JJendryka/AirMonitor/AirMonitor.kicad_pcb

## KiCad design AirMonitor.kicad_pcb (2023-12-08)

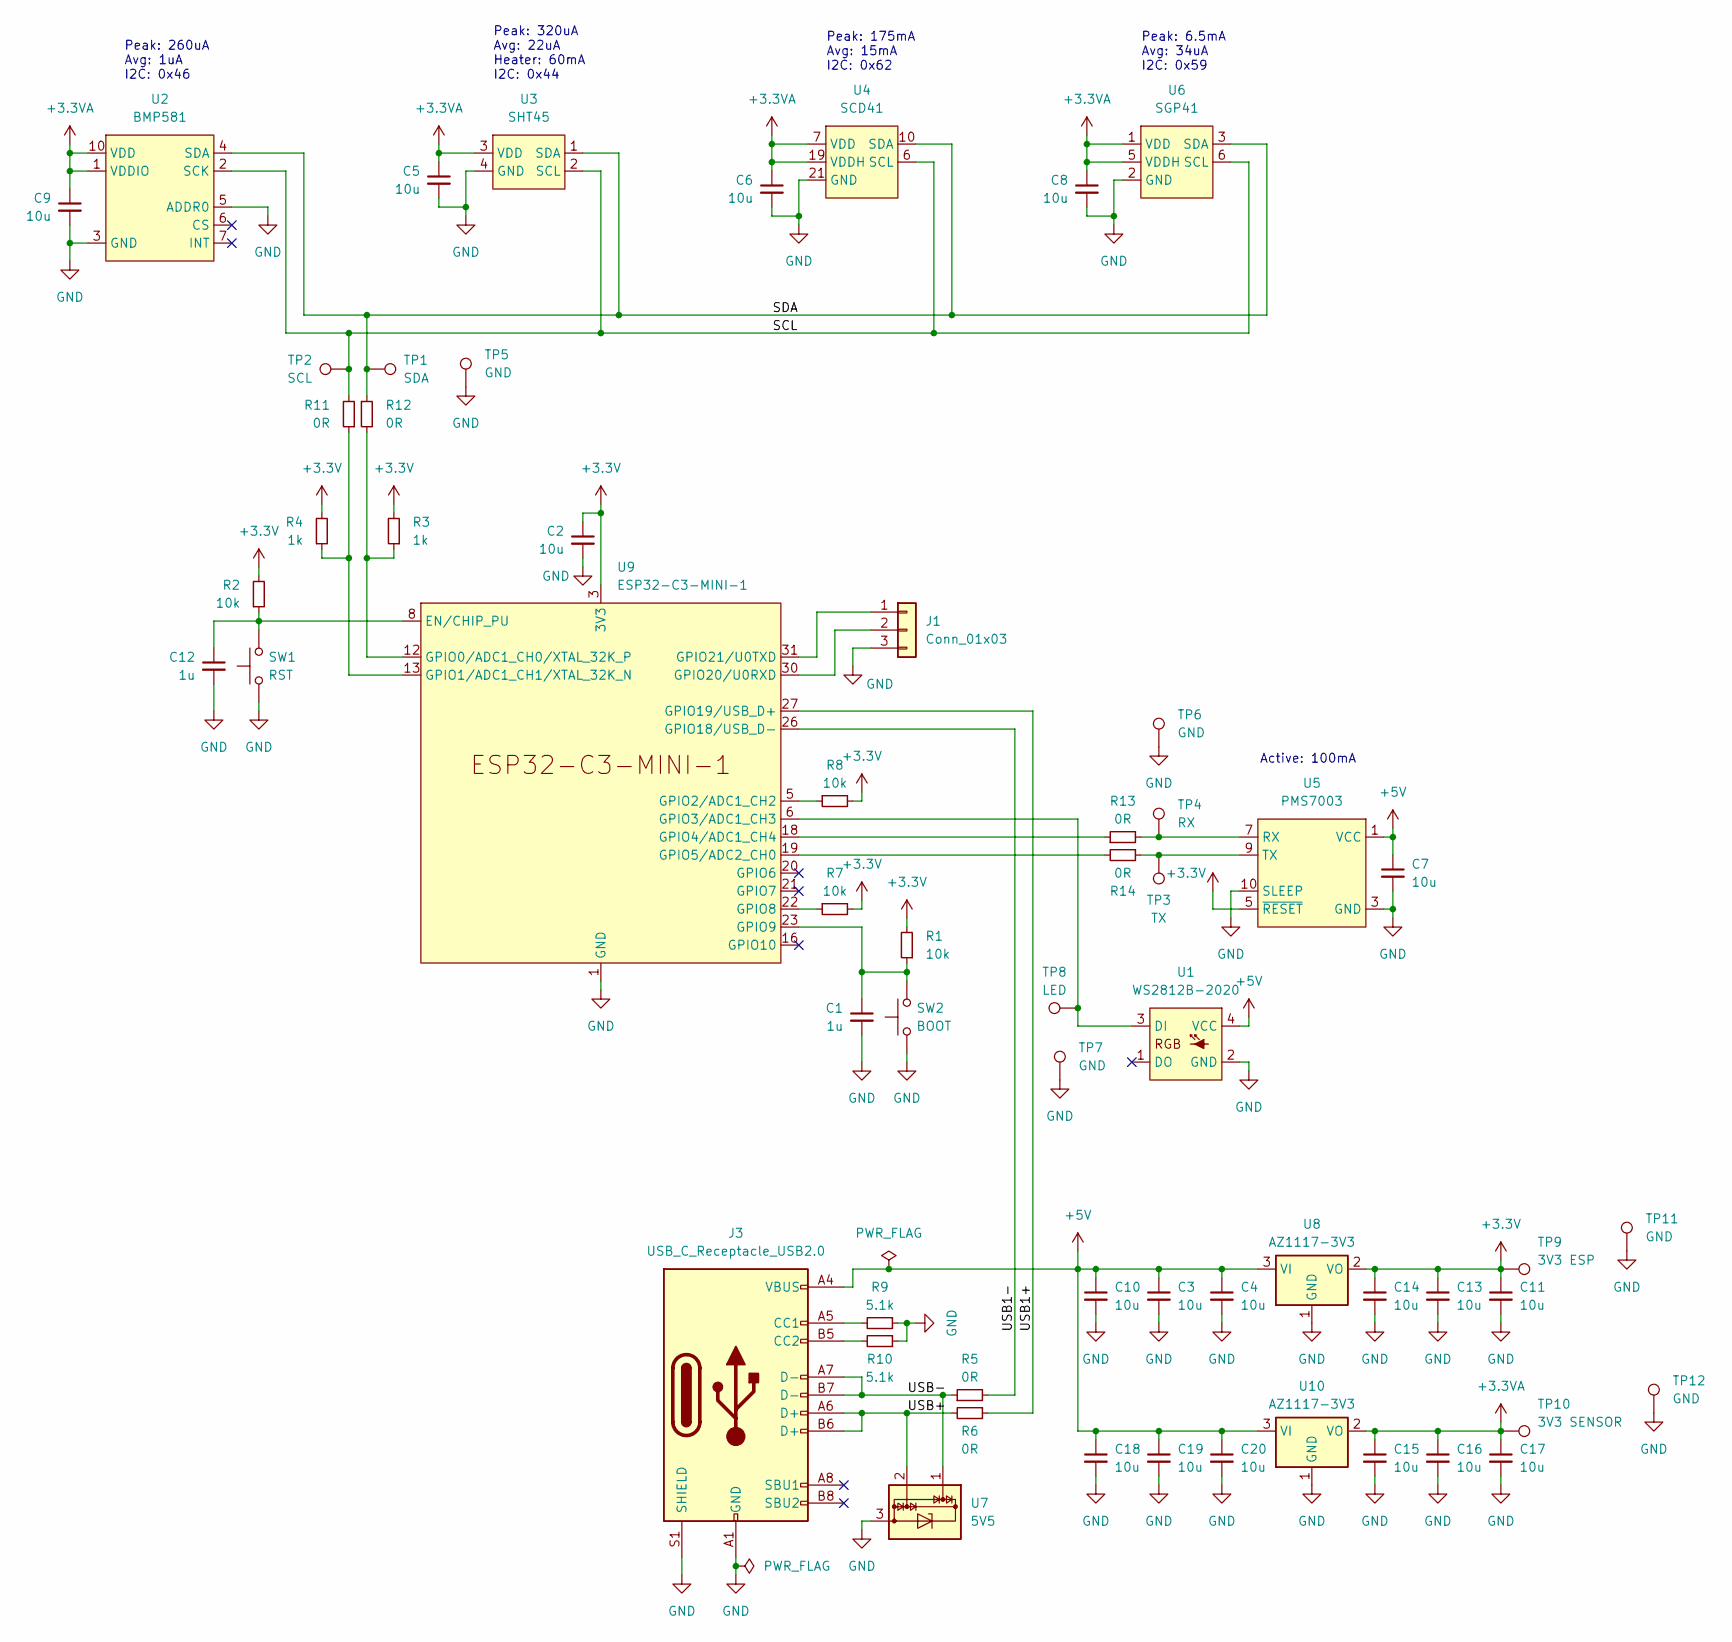
[picture p1: schematic AirMonitor.kicad_sch]

Parts:
C1, C12: 1u; C_0805_2012Metric
C2, C3, C4, C5, C6, C7, C8, C9, C10, C11, C13, C14, C15, C16, C17, C18, C19, C20: 10u; C_0805_2012Metric
J1: Conn_01x03; PinHeader_1x03_P2.54mm_Vertical_SMD_Pin1Left
J3: USB_C_Receptacle_USB2.0; USB4105-GF-A; MPN USB4105-GF-A-120; Mouser 640-USB4105-GF-A-120
R1, R2, R7, R8: 10k; R_0805_2012Metric
R3, R4: 1k; R_0805_2012Metric
R5, R6, R11, R12, R13, R14: 0R; R_0402_1005Metric_Pad0.72x0.64mm_HandSolder
R9, R10: 5.1k; R_0805_2012Metric
SW1: RST; SW_SPST_B3S-1000; MPN B3S-1000; Mouser 653-B3S-1000
SW2: BOOT; SW_SPST_B3S-1000; MPN B3S-1000; Mouser 653-B3S-1000
TP1: SDA; TestPoint_Pad_D1.0mm
TP2: SCL; TestPoint_Pad_D1.0mm
TP3: TX; TestPoint_Pad_D1.0mm
TP4: RX; TestPoint_Pad_D1.0mm
TP5, TP6, TP7, TP11, TP12: GND; TestPoint_Pad_D1.0mm
TP8: LED; TestPoint_Pad_D1.0mm
TP9: 3V3 ESP; TestPoint_Pad_D1.0mm
TP10: 3V3 SENSOR; TestPoint_Pad_D1.0mm
U1: WS2812B-2020; MPN 4684; Mouser 485-4684 - THIS IS A 10x PACK
U2: BMP581; MPN BMP581; Mouser 262-BMP581
U3: SHT45; SHT4x; MPN SHT45-AD1F-R2; Mouser 403-SHT45-AD1F-R2
U4: SCD41; SCD4x; MPN SCD41-D-R2; Mouser 403-SCD41-D-R2
U5: PMS7003; MPN PMS7003 + 20021311-00010T4LF; Mouser 649-221311-00010T4LF
U6: SGP41; DFN-6_EP_2.44x2.44_Pitch0.8mm; MPN SGP41-D-R4; Mouser 403-SGP41-D-R4
U7: 5V5; SOT-323_SC-70; MPN TPD2E2U06DCKR; Mouser 595-TPD2E2U06DCKR
U8, U10: AZ1117-3V3; SOT-223-3_TabPin2; MPN AZ1117IH-3.3TRG1; Mouser 621-AZ1117IH-3.3TRG1
U9: ESP32-C3-MINI-1

Connections:
+3.3V: C2.1, C11.1, C13.1, C14.1, R1.2, R2.2, R3.2, R4.2, R7.2, R8.2, TP9.1, U5.5 (~RESET), U8.2 (VO), U9.3 (3V3)
+3.3VA: C5.1, C6.1, C8.1, C9.1, C15.1, C16.1, C17.1, TP10.1, U2.1 (VDDIO), U2.10 (VDD), U3.3 (VDD), U4.7 (VDD), U4.19 (VDDH), U6.1 (VDD), U6.5 (VDDH), U10.2 (VO)
+5V: C3.1, C4.1, C7.1, C10.1, C18.1, C19.1, C20.1, J3.A4 (VBUS), J3.A9 (VBUS), J3.B4 (VBUS), J3.B9 (VBUS), U1.4 (VCC), U5.1 (VCC), U5.2 (VCC), U8.3 (VI), U10.3 (VI)
/SDA: R12.1, TP1.1, U2.4 (SDA), U3.1 (SDA), U4.10 (SDA), U6.3 (SDA)
/USB1+: R6.1, U9.27 (GPIO19/USB_D+)
/USB1-: R5.2, U9.26 (GPIO18/USB_D-)
/USB+: J3.A6 (D+), J3.B6 (D+), R6.2, U7.2
/USB-: J3.A7 (D-), J3.B7 (D-), R5.1, U7.1
unnamed: J1.1, U9.31 (GPIO21/U0TXD)
unnamed: J1.2, U9.30 (GPIO20/U0RXD)
unnamed: J3.A5 (CC1), R9.2
unnamed: J3.B5 (CC2), R10.2
unnamed: TP8.1, U1.3 (DI), U9.6 (GPIO3/ADC1_CH3)
unnamed: R13.2, TP4.1, U5.7 (RX)
unnamed: R14.1, TP3.1, U5.9 (TX)
unnamed: C12.1, R2.1, SW1.2, U9.8 (EN/CHIP_PU)
unnamed: R3.1, R12.2, U9.12 (GPIO0/ADC1_CH0/XTAL_32K_P)
unnamed: R4.1, R11.1, U9.13 (GPIO1/ADC1_CH1/XTAL_32K_N)
unnamed: R8.1, U9.5 (GPIO2/ADC1_CH2)
unnamed: R13.1, U9.18 (GPIO4/ADC1_CH4)
unnamed: R14.2, U9.19 (GPIO5/ADC2_CH0)
unnamed: R7.1, U9.22 (GPIO8)
unnamed: C1.1, R1.1, SW2.2, U9.23 (GPIO9)

Notes on the sheet:
Peak: 175mA Avg: 15mA I2C: 0x62
Peak: 6.5mA Avg: 34uA I2C: 0x59
Active: 100mA
Peak: 260uA Avg: 1uA I2C: 0x46
Peak: 320uA Avg: 22uA Heater: 60mA I2C: 0x44

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
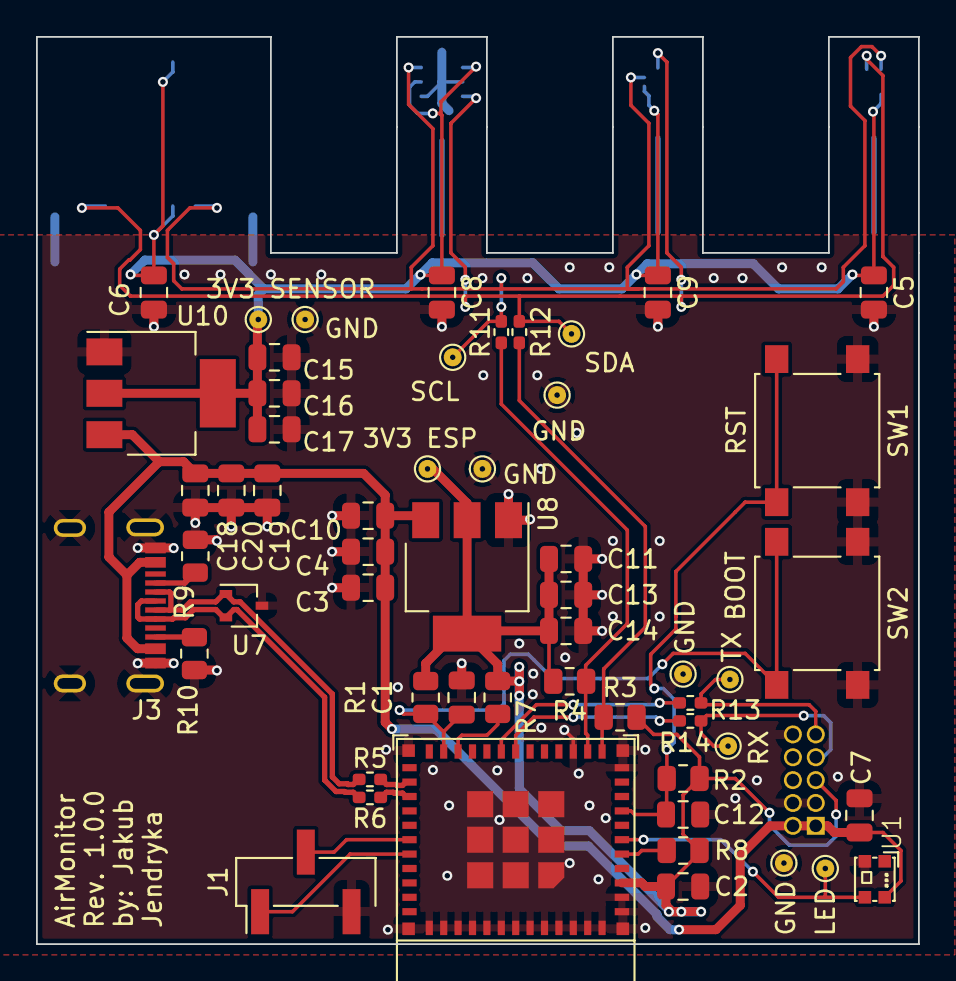
[picture p2: board AirMonitor.kicad_pcb from above]

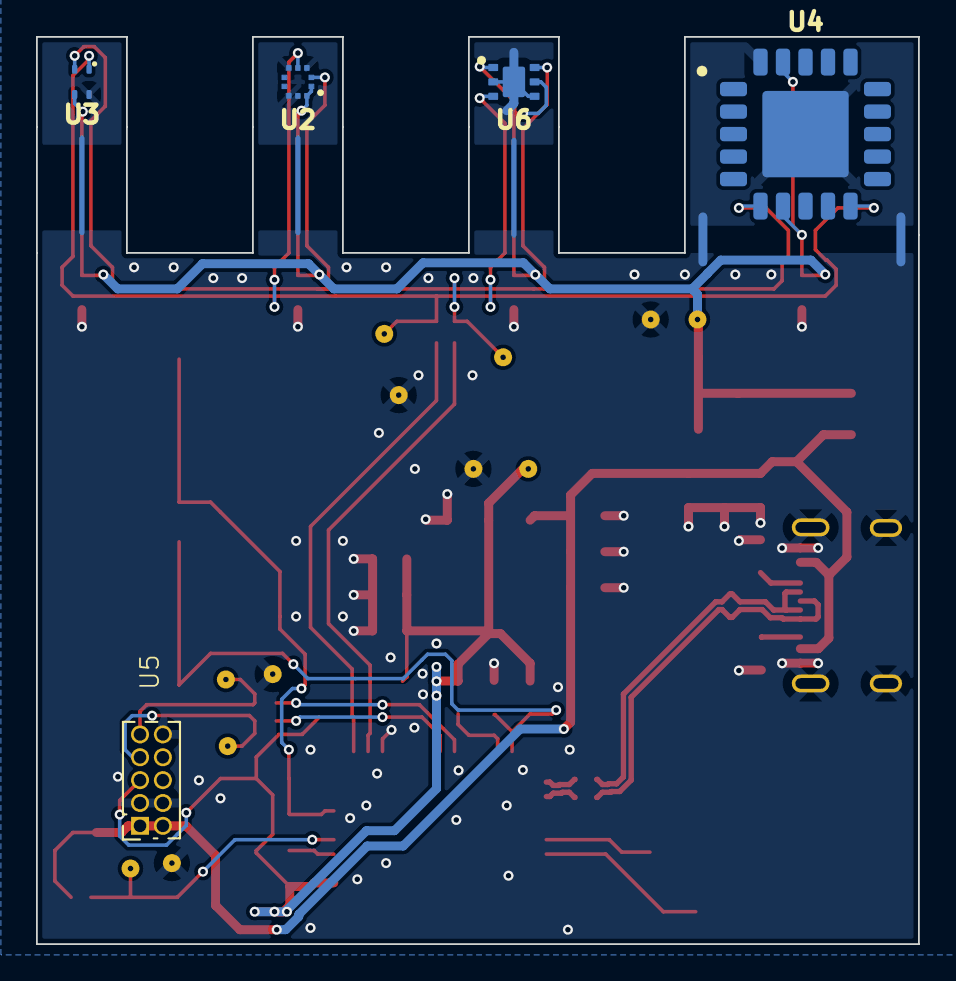
[picture p3: board AirMonitor.kicad_pcb from below]

Board: 2 copper layers, 49.0 x 50.4 mm, 60 parts (5 on the bottom side), 25 nets.
