JJendryka/AirMonitor/(commit log)

2023-12-08 Init repo
    [AirMonitor.kicad_pcb, AirMonitor.kicad_sch]
2023-12-09 Working revision
    [AirMonitor.kicad_sch]
